Geresdi-lab/Open-Hardware/CuP_filter_DC_lines/drawings/bracket.stp

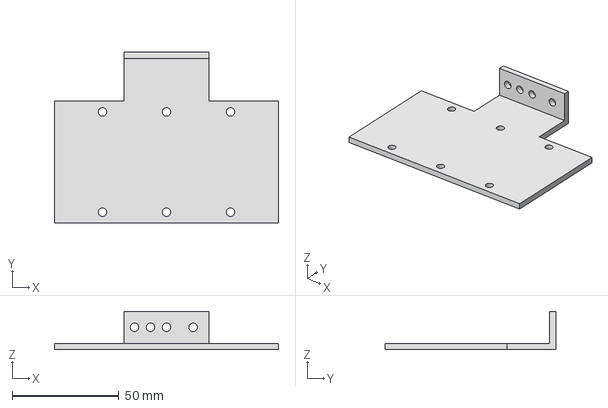
[picture p3: CAD file, 2022-09-12]
CuP_filter_DC_lines/drawings/bracket.stp
105.0 x 80.0 x 18.0 mm
