Geresdi-lab/Open-Hardware/CuP_filter_DC_lines/drawings/box_top.stp

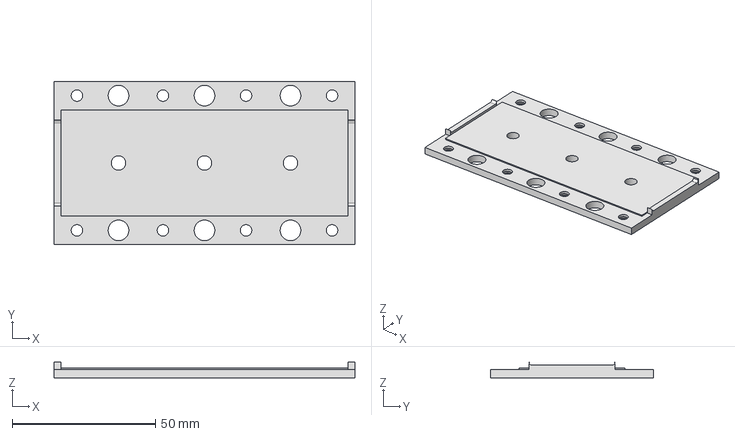
[picture p5: CAD file, 2022-09-12]
CuP_filter_DC_lines/drawings/box_top.stp
105.0 x 57.0 x 5.50 mm
