Geresdi-lab/Open-Hardware/PCB_collection/RC_filter_in_probe/RC_filter_in_probe.kicad_pcb

## KiCad design PCB_collection/RC_filter_in_probe/RC_filter_in_probe.kicad_pcb (2022-09-12)

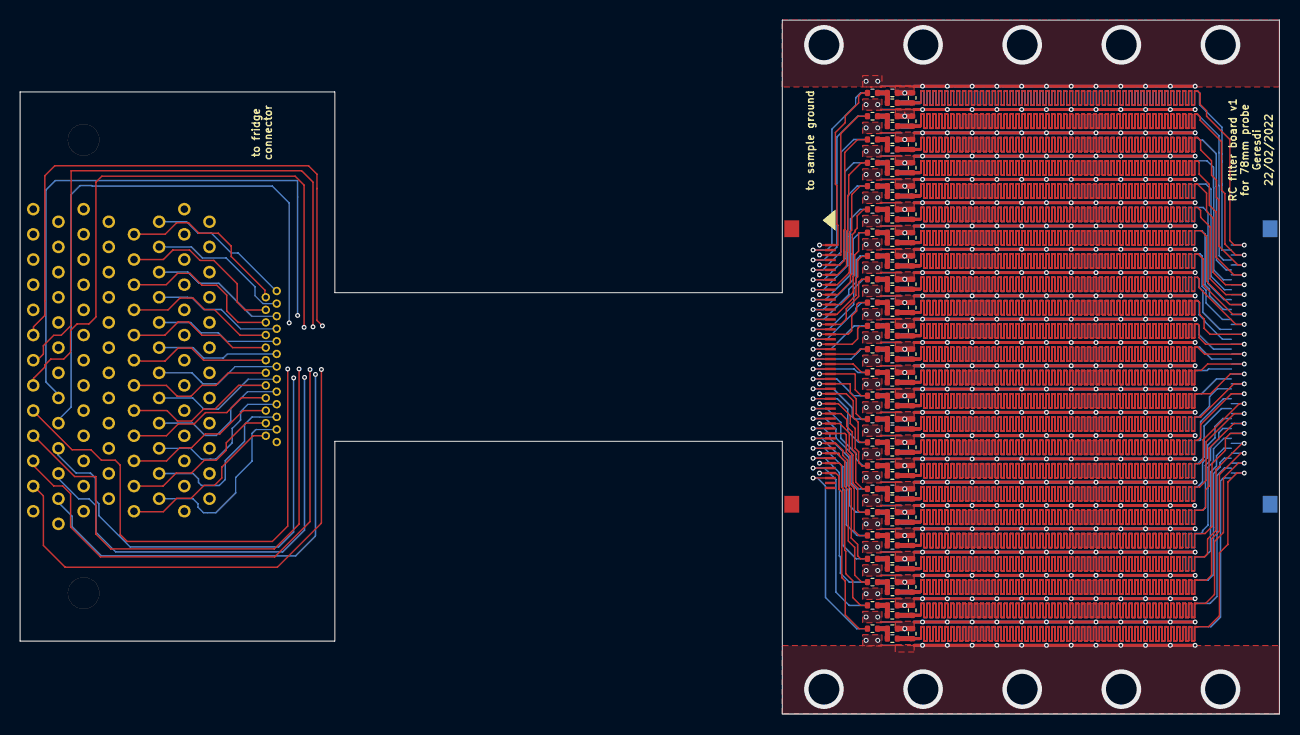
[picture p6: board RC_filter_in_probe.kicad_pcb from above]

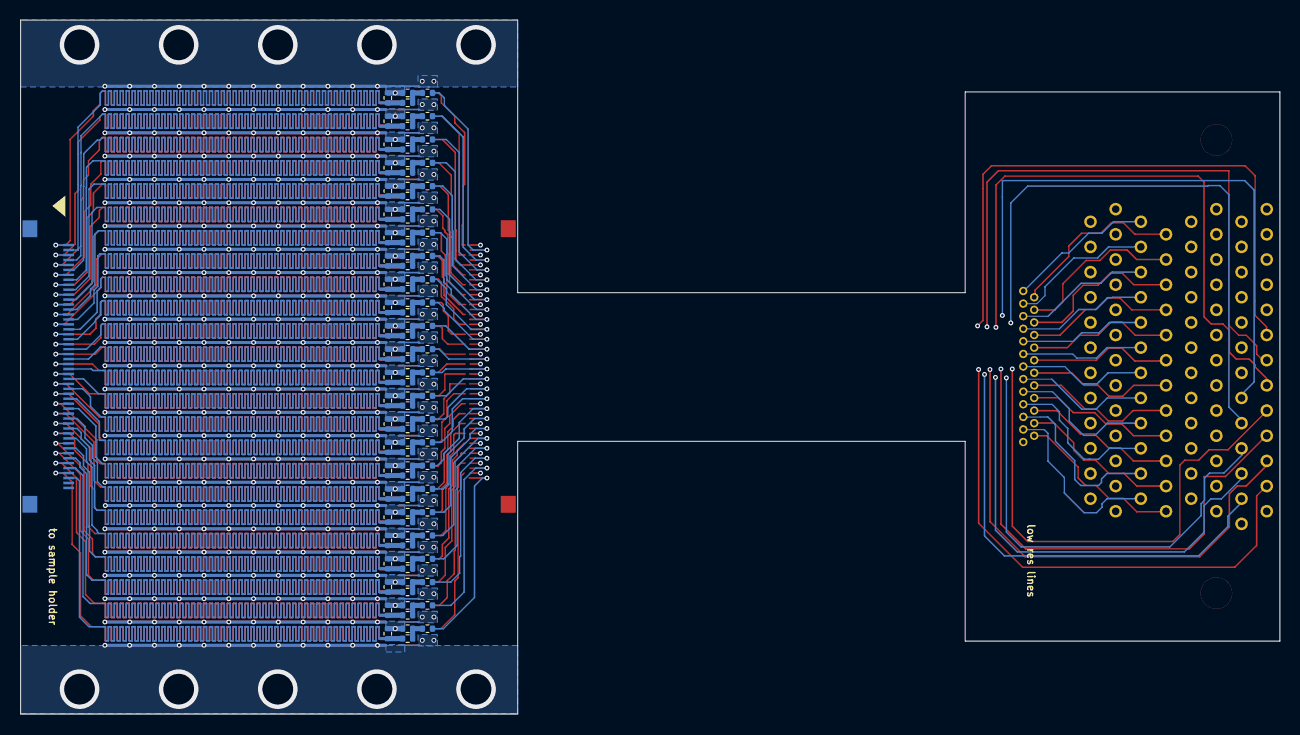
[picture p7: board RC_filter_in_probe.kicad_pcb from below]

Board: 4 copper layers, 127.1 x 70.0 mm, 196 parts (98 on the bottom side), 169 nets.

Parts:
C1, C2, C3, C4, C5, C6, C7, C8, C9, C10, C11, C12, C13, C14, C15, C16, C17, C18, C19, C20, C21, C22, C23, C24, C25, C26, C27, C28, C29, C30, C31, C32, C33, C34, C35, C36, C37, C38, C39, C40, C41, C42, C43, C44, C45, C46, C47, C48, C49, C50, C51, C52, C53, C54, C55, C56, C57, C58, C59, C60, C61, C62, C63, C64, C65, C66, C67, C68, C69, C70, C71, C72, C73, C74, C75, C76, C77, C78, C79, C80, C81, C82, C83, C84, C85, C86, C87, C88, C89, C90, C91, C92, C93, C94, C95, C96: C; R_0402_1005Metric
J1: Conn_02x50_Top_Bottom; microD_socket_100
J2: microD 25; microD_socket_25_vertical_NorComp
J3, J4: Conn_02x25_Top_Bottom; XF2M-5015-1A
R1, R2, R3, R4, R5, R6, R7, R8, R9, R10, R11, R12, R13, R14, R15, R16, R17, R18, R19, R20, R21, R22, R23, R24, R25, R26, R27, R28, R29, R30, R31, R32, R33, R34, R35, R36, R37, R38, R39, R40, R41, R42, R43, R44, R45, R46, R47, R48, R49, R50, R51, R52, R53, R54, R55, R56, R57, R58, R59, R60, R61, R62, R63, R64, R65, R66, R67, R68, R69, R70, R71, R72, R73, R74, R75, R76, R77, R78, R79, R80, R81, R82, R83, R84, R85, R86, R87, R88, R89, R90, R91, R92, R93, R94, R95, R96: R; R_0402_1005Metric

Connections:
/L01: J1.1, J3.1, R1.2
/L02: J1.2, J3.2, R3.2
/L03: J1.3, J3.3, R5.2
/L04: J1.4, J3.4, R7.2
/L05: J1.5, J3.5, R9.2
/L06: J1.6, J3.6, R11.2
/L07: J1.7, J3.7, R13.2
/L08: J1.8, J3.8, R15.2
/L09: J1.9, J3.9, R17.2
/L10: J1.10, J3.10, R19.2
/L11: J1.11, J3.11, R21.2
/L12: J1.12, J3.12, R23.2
/L13: J1.13, J3.13, R25.2
/L14: J1.14, J3.14, R27.2
/L15: J1.15, J3.15, R29.2
/L16: J1.16, J3.16, R31.2
/L17: J1.17, J3.17, R33.2
/L18: J1.18, J3.18, R35.2
/L19: J1.19, J3.19, R37.2
/L20: J1.20, J3.20, R39.2
/L21: J1.21, J3.21, R41.2
/L22: J1.22, J3.22, R43.2
/L23: J1.23, J3.23, R45.2
/L24: J1.24, J3.24, R47.2
/L25: J1.27, J3.25, R49.2
/L26: J1.28, J3.26, R51.2
/L27: J1.29, J3.27, R53.2
/L28: J1.30, J3.28, R55.2
/L29: J1.31, J3.29, R57.2
/L30: J1.32, J3.30, R59.2
/L31: J1.33, J3.31, R61.2
/L32: J1.34, J3.32, R63.2
/L33: J1.35, J3.33, R65.2
/L34: J1.36, J3.34, R67.2
/L35: J1.37, J3.35, R69.2
/L36: J1.38, J3.36, R71.2
/L37: J1.39, J3.37, R73.2
/L38: J1.40, J3.38, R75.2
/L39: J1.41, J3.39, R77.2
/L40: J1.42, J3.40, R79.2
/L41: J1.43, J3.41, R81.2
/L42: J1.44, J3.42, R83.2
/L43: J1.45, J3.43, R85.2
/L44: J1.46, J3.44, R87.2
/L45: J1.47, J3.45, R89.2
/L46: J1.48, J3.46, R91.2
/L47: J1.49, J3.47, R93.2
/L48: J1.50, J3.48, R95.2
/R01: J1.52, J2.1
/R02: J1.53, J2.14
/R03: J1.54, J2.2
/R04: J1.55, J2.15
/R05: J1.56, J2.3
/R06: J1.57, J2.16
/R07: J1.58, J2.4
/R08: J1.59, J2.17
/R09: J1.60, J2.5
/R10: J1.61, J2.18
/R11: J1.62, J2.6
/R12: J1.63, J2.19
/R13: J1.64, J2.7
/R14: J1.65, J2.20
/R15: J1.66, J2.8
/R16: J1.67, J2.21
/R17: J1.68, J2.9
/R18: J1.69, J2.22
/R19: J1.70, J2.10
/R20: J1.71, J2.23
/R21: J1.72, J2.11
/R22: J1.73, J2.24
/R23: J1.74, J2.12
/R24: J1.75, J2.25
/S01: C2.1, J4.1, R2.1
/S02: C4.1, J4.2, R4.1
/S03: C6.1, J4.3, R6.1
/S04: C8.1, J4.4, R8.1
/S05: C10.1, J4.5, R10.1
/S06: C12.1, J4.6, R12.1
/S07: C14.1, J4.7, R14.1
/S08: C16.1, J4.8, R16.1
/S09: C18.1, J4.9, R18.1
/S10: C20.1, J4.10, R20.1
/S11: C22.1, J4.11, R22.1
/S12: C24.1, J4.12, R24.1
/S13: C26.1, J4.13, R26.1
/S14: C28.1, J4.14, R28.1
/S15: C30.1, J4.15, R30.1
/S16: C32.1, J4.16, R32.1
/S17: C34.1, J4.17, R34.1
/S18: C36.1, J4.18, R36.1
/S19: C38.1, J4.19, R38.1
/S20: C40.1, J4.20, R40.1
/S21: C42.1, J4.21, R42.1
/S22: C44.1, J4.22, R44.1
/S23: C46.1, J4.23, R46.1
/S24: C48.1, J4.24, R48.1
/S25: C50.1, J4.25, R50.1
/S26: C52.1, J4.26, R52.1
/S27: C54.1, J4.27, R54.1
/S28: C56.1, J4.28, R56.1
/S29: C58.1, J4.29, R58.1
/S30: C60.1, J4.30, R60.1
/S31: C62.1, J4.31, R62.1
/S32: C64.1, J4.32, R64.1
/S33: C66.1, J4.33, R66.1
/S34: C68.1, J4.34, R68.1
/S35: C70.1, J4.35, R70.1
/S36: C72.1, J4.36, R72.1
/S37: C74.1, J4.37, R74.1
/S38: C76.1, J4.38, R76.1
/S39: C78.1, J4.39, R78.1
/S40: C80.1, J4.40, R80.1
/S41: C82.1, J4.41, R82.1
/S42: C84.1, J4.42, R84.1
/S43: C86.1, J4.43, R86.1
/S44: C88.1, J4.44, R88.1
/S45: C90.1, J4.45, R90.1
/S46: C92.1, J4.46, R92.1
/S47: C94.1, J4.47, R94.1
/S48: C96.1, J4.48, R96.1
GND: C1.2, C2.2, C3.2, C4.2, C5.2, C6.2, C7.2, C8.2, C9.2, C10.2, C11.2, C12.2, C13.2, C14.2, C15.2, C16.2, C17.2, C18.2, C19.2, C20.2, C21.2, C22.2, C23.2, C24.2, C25.2, C26.2, C27.2, C28.2, C29.2, C30.2, C31.2, C32.2, C33.2, C34.2, C35.2, C36.2, C37.2, C38.2, C39.2, C40.2, C41.2, C42.2, C43.2, C44.2, C45.2, C46.2, C47.2, C48.2, C49.2, C50.2, C51.2, C52.2, C53.2, C54.2, C55.2, C56.2, C57.2, C58.2, C59.2, C60.2, C61.2, C62.2, C63.2, C64.2, C65.2, C66.2, C67.2, C68.2, C69.2, C70.2, C71.2, C72.2, C73.2, C74.2, C75.2, C76.2, C77.2, C78.2, C79.2, C80.2, C81.2, C82.2, C83.2, C84.2, C85.2, C86.2, C87.2, C88.2, C89.2, C90.2, C91.2, C92.2, C93.2, C94.2, C95.2, C96.2
unnamed: C1.1, R1.1, R2.2
unnamed: C3.1, R3.1, R4.2
unnamed: C5.1, R5.1, R6.2
unnamed: C7.1, R7.1, R8.2
unnamed: C9.1, R9.1, R10.2
unnamed: C11.1, R11.1, R12.2
unnamed: C13.1, R13.1, R14.2
unnamed: C15.1, R15.1, R16.2
unnamed: C17.1, R17.1, R18.2
unnamed: C19.1, R19.1, R20.2
unnamed: C21.1, R21.1, R22.2
unnamed: C23.1, R23.1, R24.2
unnamed: C25.1, R25.1, R26.2
unnamed: C27.1, R27.1, R28.2
unnamed: C29.1, R29.1, R30.2
unnamed: C31.1, R31.1, R32.2
unnamed: C33.1, R33.1, R34.2
unnamed: C35.1, R35.1, R36.2
unnamed: C37.1, R37.1, R38.2
unnamed: C39.1, R39.1, R40.2
unnamed: C41.1, R41.1, R42.2
unnamed: C43.1, R43.1, R44.2
unnamed: C45.1, R45.1, R46.2
unnamed: C47.1, R47.1, R48.2
unnamed: C49.1, R49.1, R50.2
unnamed: C51.1, R51.1, R52.2
unnamed: C53.1, R53.1, R54.2
unnamed: C55.1, R55.1, R56.2
unnamed: C57.1, R57.1, R58.2
unnamed: C59.1, R59.1, R60.2
unnamed: C61.1, R61.1, R62.2
unnamed: C63.1, R63.1, R64.2
unnamed: C65.1, R65.1, R66.2
unnamed: C67.1, R67.1, R68.2
unnamed: C69.1, R69.1, R70.2
unnamed: C71.1, R71.1, R72.2
unnamed: C73.1, R73.1, R74.2
unnamed: C75.1, R75.1, R76.2
unnamed: C77.1, R77.1, R78.2
unnamed: C79.1, R79.1, R80.2
unnamed: C81.1, R81.1, R82.2
unnamed: C83.1, R83.1, R84.2
unnamed: C85.1, R85.1, R86.2
unnamed: C87.1, R87.1, R88.2
unnamed: C89.1, R89.1, R90.2
unnamed: C91.1, R91.1, R92.2
unnamed: C93.1, R93.1, R94.2
unnamed: C95.1, R95.1, R96.2
