Geresdi-lab/Open-Hardware/Cryo_switch_drive/PCB/cryo_switch_drive.kicad_pcb

## KiCad design Cryo_switch_drive/PCB/cryo_switch_drive.kicad_pcb (2022-09-11)

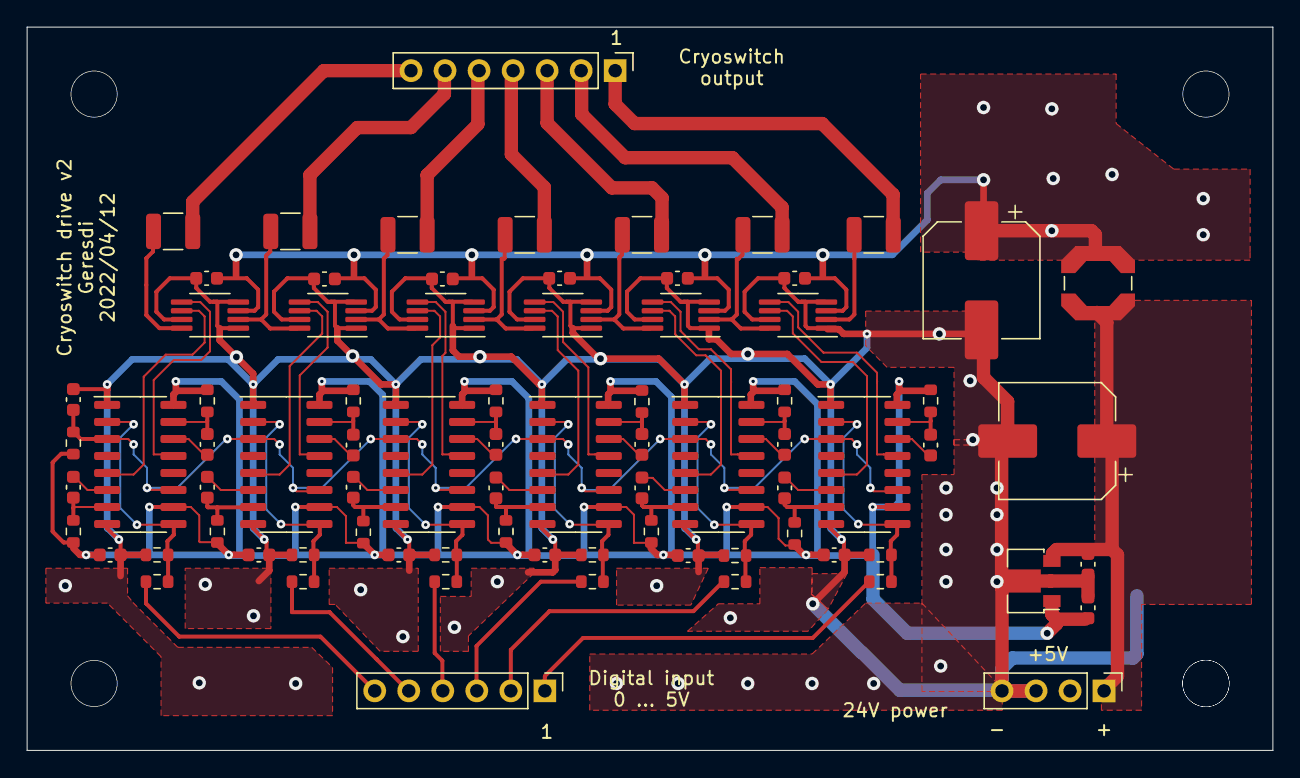
[picture p8: board cryo_switch_drive.kicad_pcb from above]

Board: 2 copper layers, 93.0 x 54.0 mm, 78 parts (0 on the bottom side), 67 nets.

Parts:
C1, C2: 100u; CP_Elec_8x10.5
C3, C4, C5, C6, C7, C8, C9, C10, C11, C12, C13, C14, C16, C18, C19, C21, C22, C24, C25, C27, C28, C30, C31, C33, C34: 100n; C_0603_1608Metric
C15: 1u; C_0603_1608Metric
C17: 330n; C_0603_1608Metric
F1, F2, F3, F4, F5, F6, F7: MF-USHT020KX-2; R_1210_3225Metric
J1: to switch connections; PinHeader_1x07_P2.54mm_Vertical
J2: battery; PinHeader_1x04_P2.54mm_Vertical
J3: control input; PinHeader_1x06_P2.54mm_Vertical
L1: 100uH; L_Coilcraft_LPS5030
R1: 50k; R_0603_1608Metric
R2, R3, R5, R6, R8, R9, R11, R12, R14, R15, R17, R18: 150k; R_0603_1608Metric
R4, R7, R10, R13, R16, R19: 47; R_0603_1608Metric
R20, R21, R22, R23, R24, R25: 330k; R_0603_1608Metric
U1, U3, U5, U7, U9, U11: BD62105; MSOP-8_3x3mm_P0.65mm
U2, U4, U6, U8, U10, U12: 74LV221A; SOIC-16_3.9x9.9mm_P1.27mm
U13: L78L05; SOT-89-3

Connections:
+5V: C9.1, C10.1, C11.1, C12.1, C13.1, C14.1, C16.1, R1.1, R2.1, R3.1, R5.1, R6.1, R8.1, R9.1, R11.1, R12.1, R14.1, R15.1, R17.1, R18.1, U2.10, U2.16, U4.10, U4.16, U6.10, U6.16, U8.10, U8.16, U10.10, U10.16, U12.10, U12.16, U13.1
GND: C1.2, C2.2, C3.1, C4.1, C5.1, C6.1, C7.1, C8.1, C9.2, C10.2, C11.2, C12.2, C13.2, C14.2, C15.2, C16.2, C17.2, J2.3, J2.4, R20.1, R21.1, R22.1, R23.1, R24.1, R25.1, U1.1, U1.4, U1.7, U2.1, U2.8, U3.1, U3.4, U3.7, U4.1, U4.8, U5.1, U5.4, U5.7, U6.1, U6.8, U7.1, U7.4, U7.7, U8.1, U8.8, U9.1, U9.4, U9.7, U10.1, U10.8, U11.1, U11.4, U11.7, U12.1, U12.8, U13.2
unnamed: C2.1, C15.1, J2.1, L1.2, U13.3
unnamed: C18.1, R3.2, U2.7
unnamed: C18.2, U2.6
unnamed: C19.1, R2.2, U2.15
unnamed: C19.2, U2.14
unnamed: C21.1, R6.2, U4.7
unnamed: C21.2, U4.6
unnamed: C22.1, R5.2, U4.15
unnamed: C22.2, U4.14
unnamed: C24.1, R9.2, U6.7
unnamed: C24.2, U6.6
unnamed: C25.1, R8.2, U6.15
unnamed: C25.2, U6.14
unnamed: C27.1, R12.2, U8.7
unnamed: C27.2, U8.6
unnamed: C28.1, R11.2, U8.15
unnamed: C28.2, U8.14
unnamed: C30.1, R15.2, U10.7
unnamed: C30.2, U10.6
unnamed: C31.1, R14.2, U10.15
unnamed: C31.2, U10.14
unnamed: C33.1, R18.2, U12.7
unnamed: C33.2, U12.6
unnamed: C34.1, R17.2, U12.15
unnamed: C34.2, U12.14
unnamed: F1.1, J1.1
unnamed: F1.2, U1.2
unnamed: F2.1, J1.2
unnamed: F2.2, U1.8, U3.2
unnamed: F3.1, J1.3
unnamed: F3.2, U3.8, U5.2
unnamed: F4.1, J1.4
unnamed: F4.2, U5.8, U7.2
unnamed: F5.1, J1.5
unnamed: F5.2, U7.8, U9.2
unnamed: F6.1, J1.6
unnamed: F6.2, U9.8, U11.2
unnamed: F7.1, J1.7
unnamed: F7.2, U11.8
unnamed: J3.1, R4.2
unnamed: J3.2, R7.2
unnamed: J3.3, R10.2
unnamed: J3.4, R13.2
unnamed: J3.5, R16.2
unnamed: J3.6, R19.2
unnamed: R10.1, R22.2, U6.2, U6.9
unnamed: R13.1, R23.2, U8.2, U8.9
unnamed: R16.1, R24.2, U10.2, U10.9
unnamed: R19.1, R25.2, U12.2, U12.9
unnamed: R4.1, R20.2, U2.2, U2.9
unnamed: R7.1, R21.2, U4.2, U4.9
unnamed: U1.5, U2.13
unnamed: U1.6, U2.5
unnamed: U3.5, U4.13
unnamed: U3.6, U4.5
unnamed: U5.5, U6.13
unnamed: U5.6, U6.5
unnamed: U7.5, U8.13
unnamed: U7.6, U8.5
unnamed: U9.6, U10.5
unnamed: U9.5, U10.13
unnamed: U11.5, U12.13
unnamed: U11.6, U12.5
VCC: C1.1, C3.2, C4.2, C5.2, C6.2, C7.2, C8.2, L1.1, U1.3, U3.3, U5.3, U7.3, U9.3, U11.3
nRST: C17.1, R1.2, U2.3, U2.11, U4.3, U4.11, U6.3, U6.11, U8.3, U8.11, U10.3, U10.11, U12.3, U12.11
