Geresdi-lab/Open-Hardware/PCB_collection/DC_sample_holder_48pins/sample48pins.kicad_pcb

## KiCad design PCB_collection/DC_sample_holder_48pins/sample48pins.kicad_pcb (2022-09-11)

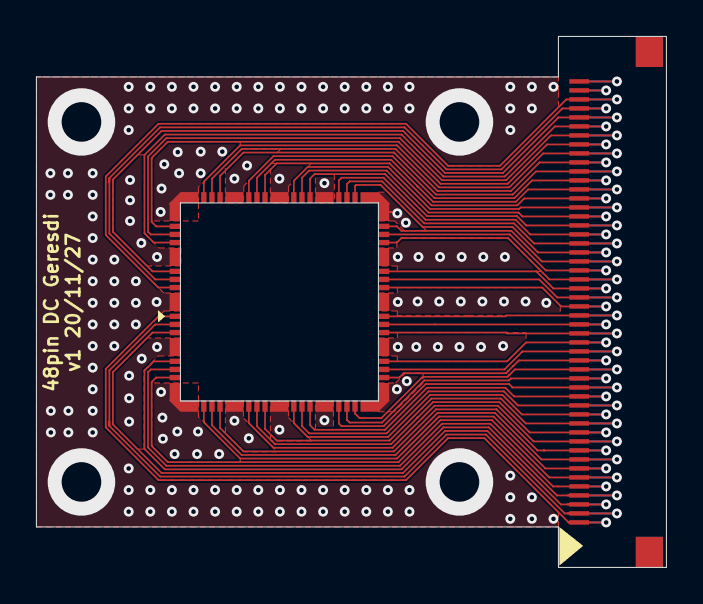
[picture p9: board sample48pins.kicad_pcb from above]

Board: 2 copper layers, 35.0 x 29.5 mm, 3 parts (1 on the bottom side), 51 nets.

Parts:
J1: edge connector up; XF2M-5015-1A
J2: edge connector down; XF2M-5015-1A
J3: PCB bond pads; 48pin_DC

Connections:
/01: J1.1, J2.50, J3.1
/02: J1.2, J2.49, J3.2
/03: J1.3, J2.48, J3.3
/04: J1.4, J2.47, J3.4
/05: J1.5, J2.46, J3.5
/06: J1.6, J2.45, J3.6
/07: J1.7, J2.44, J3.7
/08: J1.8, J2.43, J3.8
/09: J1.9, J2.42, J3.9
/10: J1.10, J2.41, J3.10
/11: J1.11, J2.40, J3.11
/12: J1.12, J2.39, J3.12
/13: J1.13, J2.38, J3.13
/14: J1.14, J2.37, J3.14
/15: J1.15, J2.36, J3.15
/16: J1.16, J2.35, J3.16
/17: J1.17, J2.34, J3.17
/18: J1.18, J2.33, J3.18
/19: J1.19, J2.32, J3.19
/20: J1.20, J2.31, J3.20
/21: J1.21, J2.30, J3.21
/22: J1.22, J2.29, J3.22
/23: J1.23, J2.28, J3.23
/24: J1.24, J2.27, J3.24
/25: J1.25, J2.26, J3.25
/26: J1.26, J2.25, J3.26
/27: J1.27, J2.24, J3.27
/28: J1.28, J2.23, J3.28
/29: J1.29, J2.22, J3.29
/30: J1.30, J2.21, J3.30
/31: J1.31, J2.20, J3.31
/32: J1.32, J2.19, J3.32
/33: J1.33, J2.18, J3.33
/34: J1.34, J2.17, J3.34
/35: J1.35, J2.16, J3.35
/36: J1.36, J2.15, J3.36
/37: J1.37, J2.14, J3.37
/38: J1.38, J2.13, J3.38
/39: J1.39, J2.12, J3.39
/40: J1.40, J2.11, J3.40
/41: J1.41, J2.10, J3.41
/42: J1.42, J2.9, J3.42
/43: J1.43, J2.8, J3.43
/44: J1.44, J2.7, J3.44
/45: J1.45, J2.6, J3.45
/46: J1.46, J2.5, J3.46
/47: J1.47, J2.4, J3.47
/48: J1.48, J2.3, J3.48
/49: J1.49, J2.2
/50: J1.50, J2.1
GND: J3.49, J3.50, J3.51, J3.52, J3.53, J3.54, J3.55, J3.56, J3.57, J3.58, J3.59, J3.60, J3.61, J3.62, J3.63, J3.64
