Geresdi-lab/Open-Hardware/(commit log)

2022-09-11 added PCBs
    PCBs used in cryogenic equipment
    [RF_holder_v1.kicad_pcb, RF_holder_v1.sch, edge_conn.kicad_pcb, edge_conn.sch, sample48pins.kicad_pcb, sample48pins.sch]
2022-09-11 added cryo switch drive circuit
    [cryo_switch_drive.kicad_pcb, cryo_switch_drive.sch]
2022-09-12 CuPowder filter box step files
    [Assembly_all.stp, Assembly_with_bracket.stp, box_bottom.stp, box_top.stp, bracket.stp]
2022-09-12 probe RC filter PCB
    [RC_filter_in_probe.kicad_pcb, RC_filter_in_probe.sch]
